cbmeeks/unified_retro_keyboard/hardware/apple2-encoder/apple-encoder.kicad_pcb

## KiCad design hardware/apple2-encoder/apple-encoder.kicad_pcb (2020-06-03)

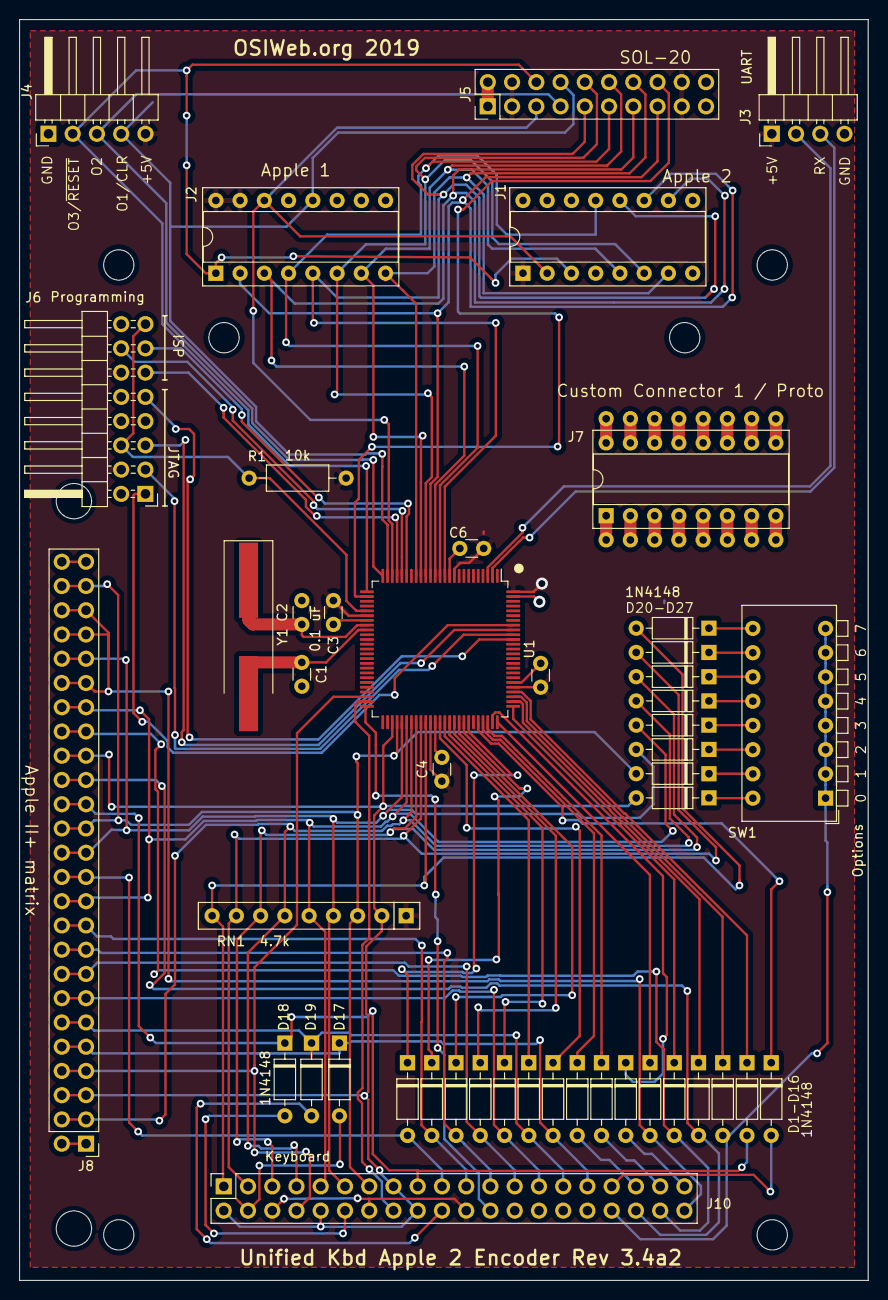
[picture p2: board apple-encoder.kicad_pcb from above]

Board: 2 copper layers, 88.9 x 132.1 mm, 49 parts (0 on the bottom side), 80 nets.

Parts:
C1, C2: 36pf; C_Disc_D3.0mm_W1.6mm_P2.50mm
C3, C4, C5, C6: 0.1 uF; C_Disc_D3.0mm_W1.6mm_P2.50mm
D1, D2, D3, D4, D5, D6, D7, D8, D9, D10, D11, D12, D13, D14, D15, D16, D17, D18, D19, D20, D21, D22, D23, D24, D25, D26, D27: 1N4148; D_DO-35_SOD27_P7.62mm_Horizontal
J1: Apple 2; DIP-16_W7.62mm_Socket
J2: Apple 1; DIP-16_W7.62mm_Socket
J3: UART; PinHeader_1x04_P2.54mm_Horizontal
J4: Conn_01x05; PinHeader_1x05_P2.54mm_Horizontal
J5: SOL-20; SOL20-header-vertical
J6: Programming; PinHeader_2x08_P2.54mm_Horizontal
J7: Custom Connector 1 / Proto; DIP-16_W7.62mm_Proto
J8: Apple II+ matrix; ExpansionHeader_1x25_P2.54
J10: Keyboard; PinHeader_2x20_P2.54mm_Vertical
MH1, MH2: Apple II; MountingHole_3.7mm
R1: 10k; R_Axial_DIN0207_L6.3mm_D2.5mm_P10.16mm_Horizontal
RN1: 4.7k; R_Array_SIP9
SW1: Options; SW_DIP_SPSTx08_Piano_CTS_Series194-8MSTN_W7.62mm_P2.54mm
U1: ATmega2560-16AU; TQFP-100_14x14mm_P0.5mm
Y1: 16.000 MHz; Crystal_SMD_HC49-SD_HandSoldering

Connections:
/Col0: D20.2, J8.3, J8.17, J10.2, J10.10, J10.15, J10.18, RN1.2, U1.53
/Col1: D24.2, J8.14, J8.24, J10.13, RN1.3, U1.54
/Col2: D21.2, J8.13, J8.21, J10.11, RN1.4, U1.55
/Col3: D25.2, J8.11, J8.19, J10.9, RN1.5, U1.56
/Col4: D22.2, J8.2, J10.7, RN1.6, U1.57
/Col5: D26.2, J10.5, RN1.7, U1.58
/Col6: D23.2, J10.3, RN1.8, U1.59
/Col7: D27.2, J10.1, RN1.9, U1.60
/D0: J1.12, J2.5, J5.5, U1.12
/D1: J1.13, J2.4, J5.6, U1.13
/D2: J1.10, J2.3, J5.7, U1.14
/D3: J1.11, J2.2, J5.8, U1.15
/D4: J1.6, J2.6, J5.15, U1.16
/D5: J1.5, J2.7, J5.16, U1.17
/D6: J1.7, J2.8, J5.17, U1.18
/D7: J5.18, U1.27
/LED1: J8.4, J10.8, U1.48
/LED2: J10.16, U1.49
/LED3: J10.24, U1.50
/MISO: J6.11, U1.22
/MOSI: J6.14, U1.21
/OUT1: J2.12, J4.4, J5.14, U1.24
/OUT2: J4.3, J5.4, U1.25
/OUT3: J1.3, J2.1, J4.2, J5.13, U1.26
/Row0: D9.2, D17.1, J8.5, J10.31
/Row1: D1.2, D19.1, J8.6, J10.29
/Row2: D10.2, J8.7, J10.27
/Row3: D2.2, J8.8, J10.25
/Row4: D11.2, J8.9, J10.23
/Row5: D3.2, J8.10, J10.21
/Row6: D12.2, J8.12, J10.19
/Row7: D4.2, D18.1, J8.15, J10.17
/Row8: D13.2, J10.34, SW1.1, SW1.2, SW1.3, SW1.4, SW1.5, SW1.6, SW1.7, SW1.8
/Row9: D5.2, J8.16, J10.36
/Row10: D14.2, J8.18, J10.38
/Row11: D6.2, J8.20, J8.22, J8.23, J10.40
/Row12: D15.2, J10.39
/Row13: D7.2, J10.37
/Row14: D16.2, J10.35
/Row15: D8.2, J10.33
/Rx: J3.3, U1.2
/SCK: J6.13, U1.20
/TCK: J6.1, U1.93
/TDI: J6.9, U1.90
/TDO: J6.3, U1.91
/TMS: J6.5, U1.92
/Tx: J3.2, U1.3
/~RESET: J6.6, J6.15, R1.2, U1.30
/~STROBE: J1.2, J2.14, J5.3, U1.23
GND: C1.2, C2.2, C3.2, C4.2, C5.2, C6.2, J1.8, J2.9, J3.4, J4.1, J5.1, J5.10, J5.11, J5.20, J6.2, J6.10, J6.16, U1.11, U1.32, U1.62, U1.81, U1.99
unnamed: C1.1, U1.34, Y1.2
unnamed: C2.1, U1.33, Y1.1
unnamed: D1.1, U1.64
unnamed: D2.1, U1.66
unnamed: D3.1, U1.68
unnamed: D4.1, U1.79
unnamed: D5.1, U1.77
unnamed: D6.1, U1.75
unnamed: D7.1, U1.73
unnamed: D8.1, U1.71
unnamed: D9.1, U1.63
unnamed: D10.1, U1.65
unnamed: D11.1, U1.67
unnamed: D12.1, U1.69
unnamed: D13.1, U1.78
unnamed: D14.1, U1.76
unnamed: D15.1, U1.74
unnamed: D16.1, U1.72
unnamed: D17.2, J10.4
unnamed: D18.2, J10.12
unnamed: D19.2, J10.20
unnamed: D20.1, SW1.16
unnamed: D21.1, SW1.14
unnamed: D22.1, SW1.12
unnamed: D23.1, SW1.10
unnamed: D24.1, SW1.15
unnamed: D25.1, SW1.13
unnamed: D26.1, SW1.11
unnamed: D27.1, SW1.9
VCC: C3.1, C4.1, C5.1, C6.1, J1.1, J2.15, J2.16, J3.1, J4.5, J5.2, J5.9, J5.12, J5.19, J6.4, J6.12, J10.6, J10.14, J10.22, R1.1, RN1.1, U1.10, U1.31, U1.61, U1.80, U1.100
