cbmeeks/unified_retro_keyboard/(commit log)

2020-06-03 Add wiring for apple-II two-piece encoder replacement
    [interface-ascii-2560.kicad_pcb, interface-ascii-2560.sch]
2020-06-03 Remove extraneous silk screen text
    [interface-ascii-2560.kicad_pcb]
2020-06-03 Add apple 2 encoder board (pre-customized ASCII Interface (2560)
    [apple-encoder.kicad_pcb, apple-encoder.sch]
